valeronm/Li-Po-Charger/README.md

# Li-Po-Charger
Schematic and PCB for Li-Po charger with power path, power management inputs, charging state and 3.3V output and I2C fuel gauge
