valeronm/Li-Po-Charger/Li-Po Charger.kicad_pcb

## KiCad design Li-Po Charger.kicad_pcb (2026-10-12)

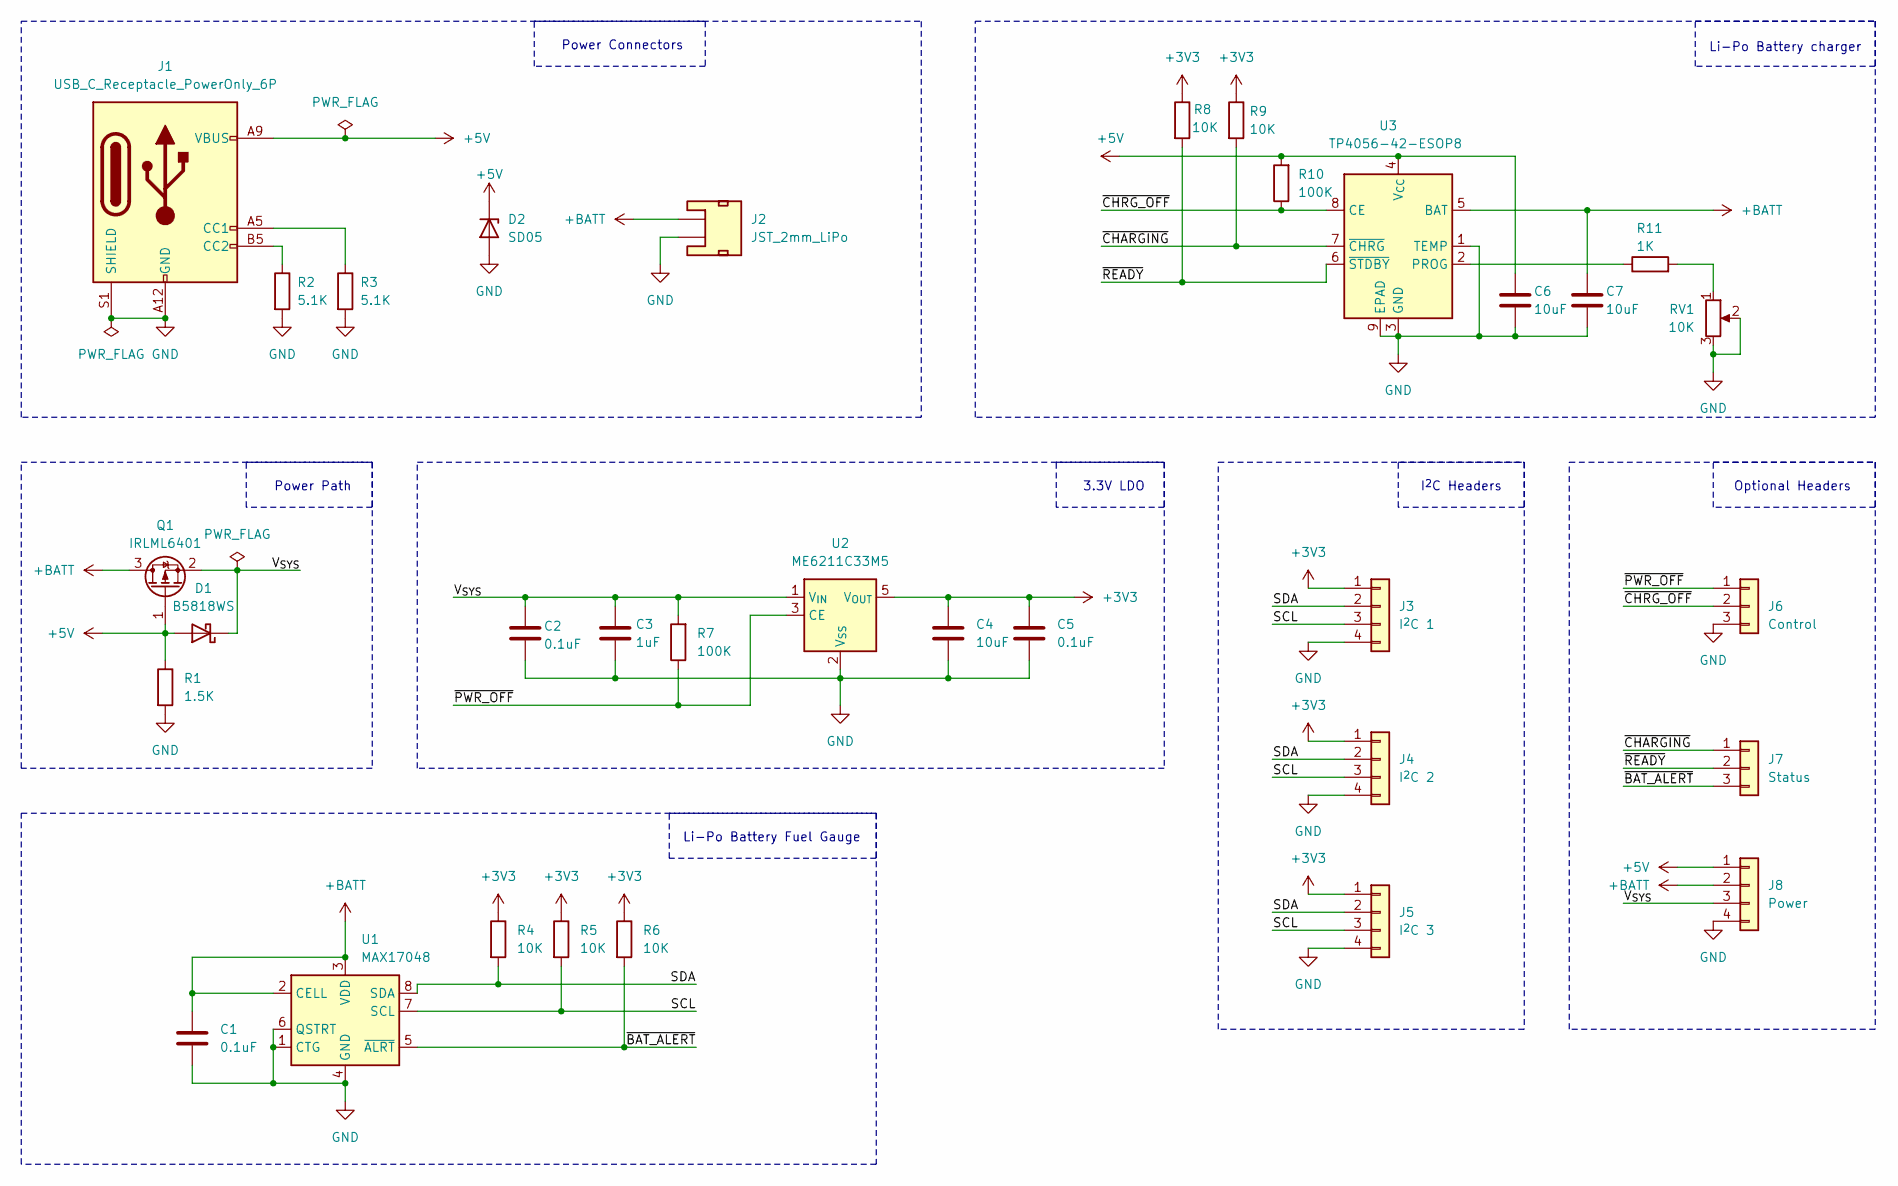
[picture p1: schematic Li-Po Charger.kicad_sch]

Parts:
C1, C2, C5: 0.1uF; C_0402_1005Metric
C3: 1uF; C_0603_1608Metric
C4, C6, C7: 10uF; C_0603_1608Metric
D1: B5818WS; D_SOD-323; LCSC Part # C22466361
D2: SD05; D_SOD-323; LCSC Part # C502527
J1: USB_C_Receptacle_PowerOnly_6P; USB_C_Receptacle_HRO_TYPE-C-31-M-17; LCSC Part # C283540
J2: JST_2mm_LiPo; JST_1x02_P2.0mm_Horizontal_SMD; LCSC Part # C295747
J3: I^{2}C 1; PinHeader_1x04_P2.54mm_Vertical
J4: I^{2}C 2; PinHeader_1x04_P2.54mm_Vertical
J5: I^{2}C 3; PinHeader_1x04_P2.54mm_Vertical
J6: Control; PinHeader_1x03_P2.54mm_Vertical
J7: Status; PinHeader_1x03_P2.54mm_Vertical
J8: Power; PinHeader_1x04_P2.54mm_Vertical
Q1: IRLML6401; SOT-23-3; LCSC Part # C382329
R1: 1.5K; R_0402_1005Metric
R2, R3: 5.1K; R_0402_1005Metric
R4, R5, R6, R8, R9: 10K; R_0402_1005Metric
R7, R10: 100K; R_0402_1005Metric
R11: 1K; R_0402_1005Metric
RV1: 10K; Potentiometer_Bourns_TC33X_Vertical; LCSC Part # C719176
U1: MAX17048; DFN-8-1EP_2x2mm_P0.5mm_EP0.8x1.6mm; LCSC Part # C2682616
U2: ME6211C33M5; SOT-23-5; LCSC Part # C82942
U3: TP4056-42-ESOP8; SOIC-8-1EP_3.9x4.9mm_P1.27mm_EP2.41x3.3mm; LCSC Part # C16581

Connections:
+3V3: C4.1, C5.1, J3.1, J4.1, J5.1, R4.1, R5.1, R6.1, R8.1, R9.1, U2.5 (V_{OUT})
+5V: C6.1, D1.2 (A), D2.1 (K), J1.A9 (VBUS), J1.B9 (VBUS), J8.1, Q1.1 (G), R1.1, R10.2, U3.4 (V_{CC})
+BATT: C1.1, C7.1, J2.2 (+), J8.2, Q1.3 (D), U1.2 (CELL), U1.3 (VDD), U3.5 (BAT)
/SCL: J3.3, J4.3, J5.3, R5.2, U1.7 (SCL)
/SDA: J3.2, J4.2, J5.2, R4.2, U1.8 (SDA)
/V_{SYS}: C2.1, C3.1, D1.1 (K), J8.3, Q1.2 (S), R7.2, U2.1 (V_{IN})
/~BAT_ALERT: J7.3, R6.2, U1.5 (~ALRT)
/~CHARGING: J7.1, R9.2, U3.7 (~CHRG)
/~CHRG_OFF: J6.2, R10.1, U3.8 (CE)
/~PWR_OFF: J6.1, R7.1, U2.3 (CE)
/~READY: J7.2, R8.2, U3.6 (~STDBY)
GND: C1.2, C2.2, C3.2, C4.2, C5.2, C6.2, C7.2, D2.2 (A), J1.A12 (GND), J1.B12 (GND), J1.S1 (SHIELD), J2.1 (-), J3.4, J4.4, J5.4, J6.3, J8.4, R1.2, R2.2, R3.2, RV1.2, RV1.3, U1.1 (CTG), U1.4 (GND), U1.6 (QSTRT), U1.9 (GND), U2.2 (V_{SS}), U3.1 (TEMP), U3.3 (GND), U3.9 (EPAD)
unnamed: J1.A5 (CC1), R3.1
unnamed: J1.B5 (CC2), R2.1
unnamed: R11.2, RV1.1
unnamed: R11.1, U3.2 (PROG)

Notes on the sheet:
Optional Headers
Li-Po Battery Fuel Gauge
Power Connectors
Li-Po Battery charger
3.3V LDO
I^{2}C Headers
Power Path

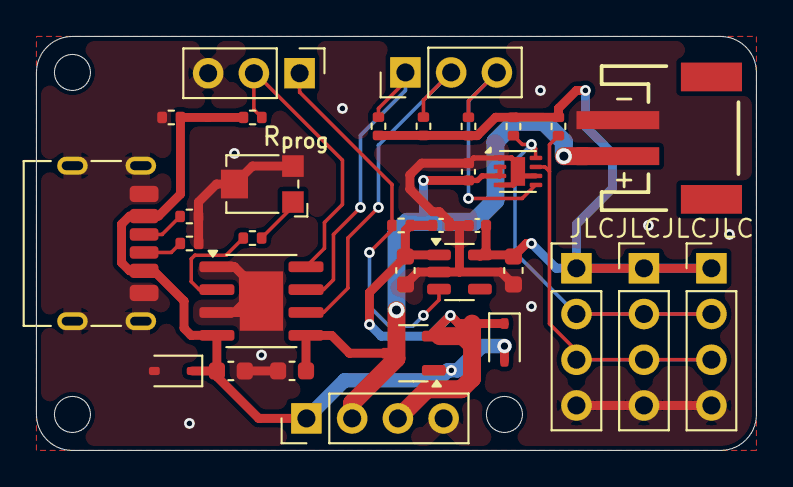
[picture p2: board Li-Po Charger.kicad_pcb from above]

Board: 2 copper layers, 40.0 x 23.0 mm, 33 parts (0 on the bottom side), 16 nets.
