valeronm/Li-Po-Charger/(commit log)

2026-10-12 Pin line endings to LF with a .gitattributes
    A checkout with autocrlf on leaves CRLF in the working files, and a
    clone without it then reports every line of them as changed.
2026-10-12 Revise the board following a design review
    With R1 at 10K the load ran through Q1's body diode for about 35 ms
    after USB was unplugged; 1.5K shortens that to about 5 ms. A USB host
    expects about 10 uF at plug-in, and C3 was the part of it that could
    shrink. Plug-in ringing on VBUS reaches the LDO through D1, and the
    LDO's 6.5 V limit is the lowest on that rail.
    PWR_OFF and CHRG_OFF are pulled up, so the 3.3 V rail and charging are
    on until a pin is driven low.
    The LDO cannot feed an amplifier or a motor, which take V_SYS or the
    battery from J8. A track running down to J8 on the back cuts the ground
    pour that joins the USB side to the battery side, so the battery and
    V_SYS reach it on the f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
2026-10-12 Ignore KiCad's local-history folder
    KiCad 10 keeps its own snapshots of the project in .history, with a
    git repository of its own inside.
